eisl-nctu/aquila-net/aquila_hw_network/network_module/iprepo/arp_server_subnet/doc/ReleaseNotes.txt

# ==============================================================
# Vivado(TM) HLS - High-Level Synthesis from C, C++ and SystemC v2019.1 (64-bit)
# Copyright 1986-2019 Xilinx, Inc. All Rights Reserved.
# ==============================================================

Family       : kintex7
Device       : xc7k325t
Package      : -ffg900
Speed Grade  : -2
Clock Period : 6.400 ns
