eisl-nctu/aquila-net/aquila_lwip/sw/socket_echo/lwipopts.h

#define LWIP_LWIPOPTS_H
#define DEFAULT_UDP_RECVMBOX_SIZE       10
#define DEFAULT_TCP_RECVMBOX_SIZE       10
#define DEFAULT_ACCEPTMBOX_SIZE         10
#define DEFAULT_THREAD_STACKSIZE        4096
#define TCPIP_THREAD_NAME               "lwip"
#define TCPIP_THREAD_STACKSIZE          4096
#define TCPIP_MBOX_SIZE                 4
#define TCPIP_THREAD_PRIO               6
#define LWIP_IPV4                  1
#define LWIP_IPV6                  0
#define NO_SYS                     0
#define LWIP_SOCKET                (NO_SYS==0)
#define LWIP_NETCONN               (NO_SYS==0)
#define LWIP_NETIF_API             (NO_SYS==0)
#define LWIP_IGMP                  LWIP_IPV4
#define LWIP_ICMP                  LWIP_IPV4
#define LWIP_SNMP                  LWIP_UDP
#define MIB2_STATS                 LWIP_SNMP
#ifdef LWIP_HAVE_MBEDTLS
#define LWIP_SNMP_V3               (LWIP_SNMP)
#endif
#define LWIP_DNS                   LWIP_UDP
#define LWIP_MDNS_RESPONDER        LWIP_UDP
#define LWIP_NUM_NETIF_CLIENT_DATA (LWIP_MDNS_RESPONDER)
#define LWIP_HAVE_LOOPIF           1
#define LWIP_NETIF_LOOPBACK        1
#define LWIP_LOOPBACK_MAX_PBUFS    10
#define TCP_LISTEN_BACKLOG         1
#define LWIP_COMPAT_SOCKETS        0
#define LWIP_SO_RCVTIMEO           1
#define LWIP_SO_RCVBUF             1
#define LWIP_TCPIP_CORE_LOCKING    1
#define LWIP_NETIF_LINK_CALLBACK        0
#define LWIP_NETIF_STATUS_CALLBACK      0
#define LWIP_NETIF_EXT_STATUS_CALLBACK  0
#define LWIP_DBG_TYPES_ON         (LWIP_DBG_ON|LWIP_DBG_TRACE|LWIP_DBG_STATE|LWIP_DBG_FRESH|LWIP_DBG_HALT)
#define MEM_ALIGNMENT           4U
#define MEM_SIZE               10240
#define MEMP_NUM_PBUF           16
#define MEMP_NUM_RAW_PCB        3
#define MEMP_NUM_UDP_PCB        4
#define MEMP_NUM_TCP_PCB        5
#define MEMP_NUM_TCP_PCB_LISTEN 8
#define MEMP_NUM_TCP_SEG        16
#define MEMP_NUM_SYS_TIMEOUT    17
#define MEMP_NUM_NETBUF         2
#define MEMP_NUM_NETCONN        10
#define MEMP_NUM_TCPIP_MSG_API   16
#define MEMP_NUM_TCPIP_MSG_INPKT 16
#define PBUF_POOL_SIZE          120
#define PBUF_POOL_BUFSIZE       256
#define SYS_LIGHTWEIGHT_PROT    (NO_SYS==0)
#define LWIP_TCP                1
#define TCP_TTL                 255
#define LWIP_ALTCP              (LWIP_TCP)
#ifdef LWIP_HAVE_MBEDTLS
#define LWIP_ALTCP_TLS          (LWIP_TCP)
#define LWIP_ALTCP_TLS_MBEDTLS  (LWIP_TCP)
#endif
#define TCP_QUEUE_OOSEQ         1
#define TCP_MSS                 2048
#define TCP_SND_BUF             2 * TCP_MSS
#define TCP_SND_QUEUELEN       (4 * TCP_SND_BUF/TCP_MSS)
#define TCP_SNDLOWAT           (TCP_SND_BUF/2)
#define TCP_WND                 (20 * 1024)
#define TCP_MAXRTX              12
#define TCP_SYNMAXRTX           4
#define LWIP_ARP                1
#define ARP_TABLE_SIZE          10
#define ARP_QUEUEING            1
#define IP_FORWARD              1
#define IP_REASSEMBLY           1
#define IP_REASS_MAX_PBUFS      (10 * ((1500 + PBUF_POOL_BUFSIZE - 1) / PBUF_POOL_BUFSIZE))
#define MEMP_NUM_REASSDATA      IP_REASS_MAX_PBUFS
#define IP_FRAG                 1
#define IPV6_FRAG_COPYHEADER    1
#define ICMP_TTL                255
#define LWIP_DHCP               LWIP_UDP
#define DHCP_DOES_ARP_CHECK    (LWIP_DHCP)
#define LWIP_AUTOIP            (LWIP_DHCP)
#define LWIP_DHCP_AUTOIP_COOP  (LWIP_DHCP && LWIP_AUTOIP)
#define LWIP_UDP                1
#define LWIP_UDPLITE            LWIP_UDP
#define UDP_TTL                 255
#define LWIP_RAW                1
#define LWIP_STATS              1
#define LWIP_STATS_DISPLAY      1
#if LWIP_STATS
#define LINK_STATS              1
#define IP_STATS                1
#define ICMP_STATS              1
#define IGMP_STATS              1
#define IPFRAG_STATS            1
#define UDP_STATS               1
#define TCP_STATS               1
#define MEM_STATS               1
#define MEMP_STATS              1
#define PBUF_STATS              1
#define SYS_STATS               1
#endif
#define LWIP_NETBIOS_RESPOND_NAME_QUERY 1
#define PPP_SUPPORT             0
#if PPP_SUPPORT
#define NUM_PPP                 1
#define PPPOE_SUPPORT           1
#define PPPOS_SUPPORT           1
#define PAP_SUPPORT             1
#define CHAP_SUPPORT            1
#define MSCHAP_SUPPORT          0
#define CBCP_SUPPORT            0
#define CCP_SUPPORT             0
#define VJ_SUPPORT              1
#define MD5_SUPPORT             1
#endif
