eisl-nctu/aquila-net/aquila_lwip/aquila_src/soc_top.v

`timescale 1ns / 1ps
// =============================================================================
//  Program : soc_top.v
//  Author  : Chun-Jen Tsai
//  Date    : Feb/16/2020
// -----------------------------------------------------------------------------
//  Description:
//  This is the top-level Aquila IP wrapper for an AXI-based processor SoC.
// -----------------------------------------------------------------------------
//  Revision information:
//
//  This module is based on the soc_top.v module written by Jin-you Wu
//  on Feb/28/2019. The original module was a stand-alone top-level module
//  for an SoC. This rework makes it a module embedded inside an AXI IP.
//
//  Jan/12/2020, by Chun-Jen Tsai:
//    Added a on-chip Tightly-Coupled Memory (TCM) to the aquila SoC.
//
// -----------------------------------------------------------------------------
//  License information:
//
//  This software is released under the BSD-3-Clause Licence,
//  see https://opensource.org/licenses/BSD-3-Clause for details.
//  In the following license statements, "software" refers to the
//  "source code" of the complete hardware/software system.
//
//  Copyright 2019,
//                    Embedded Intelligent Systems Lab (EISL)
//                    Deparment of Computer Science
//                    National Chiao Tung Uniersity
//                    Hsinchu, Taiwan.
//
//  All rights reserved.
//
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
//  3. Neither the name of the copyright holder nor the names of its contributors
//     may be used to endorse or promote products derived from this software
//     without specific prior written permission.
//
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
module soc_top #( parameter XLEN = 32, parameter CLSIZE = 256 )
(
    input           sys_clk_p,
    input           sys_clk_n,
    input           reset,

    // ddr3
    output [13 : 0] ddr3_addr,
    output [2 : 0]  ddr3_ba,
    output          ddr3_cas_n,
    output [0 : 0]  ddr3_ck_n,
    output [0 : 0]  ddr3_ck_p,
    output [0 : 0]  ddr3_cke,
    output          ddr3_ras_n,
    output          ddr3_reset_n,
    output          ddr3_we_n,
    inout  [63 : 0] ddr3_dq,
    inout  [7 : 0]  ddr3_dqs_n,
    inout  [7 : 0]  ddr3_dqs_p,
    output [0 : 0]  ddr3_cs_n,
    output [7 : 0]  ddr3_dm,
    output [0 : 0]  ddr3_odt,

    // sdcard
    output          spi_mosi,
    input           spi_miso,
    output          spi_sck,
    output [0:0]    spi_ss,

    // uart
    input           uart_rx,
    output          uart_tx,

    // buttons & leds
    input  [0 : 4]  usr_btn,
    output [0 : 4]  usr_led,

    // ethernet (1000BASE-T SGMII)
    input           phy_sgmii_rx_p,
    input           phy_sgmii_rx_n,
    output          phy_sgmii_tx_p,
    output          phy_sgmii_tx_n,
    input           phy_sgmii_clk_p,
    input           phy_sgmii_clk_n,
    output          phy_reset_n,
    input           phy_int_n
);

wire ui_clk, clk, clk_125;
wire ui_rst;
reg  rst;

wire phy_sgmii_resetdone;

// --------- External memory interface -----------------------------------------
// Instruction memory ports
wire                IMEM_strobe;
wire [XLEN-1 : 0]   IMEM_addr;
wire                IMEM_done;
wire [CLSIZE-1 : 0] IMEM_data;

// Data memory ports
wire                DMEM_strobe;
wire [XLEN-1 : 0]   DMEM_addr;
wire                DMEM_rw;
wire [CLSIZE-1 : 0] DMEM_wt_data;
wire                DMEM_done;
wire [CLSIZE-1 : 0] DMEM_rd_data;

// --------- I/O device interface ----------------------------------------------
// Device bus signals
wire                dev_strobe;
wire [XLEN-1 : 0]   dev_addr;
wire                dev_we;
wire [XLEN/8-1 : 0] dev_be;
wire [XLEN-1 : 0]   dev_din;
wire [XLEN-1 : 0]   dev_dout;
wire                dev_ready;

// --------- cdc_sync ----------------------------------------------------------
// Instruction Memory
wire                IMEM_strobe_ui_clk;
wire [XLEN-1 : 0]   IMEM_addr_ui_clk;
wire                IMEM_done_ui_clk;
wire [CLSIZE-1 : 0] IMEM_data_ui_clk;

// Data Memory
wire                DMEM_strobe_ui_clk;
wire [XLEN-1 : 0]   DMEM_addr_ui_clk;
wire                DMEM_rw_ui_clk;
wire [CLSIZE-1 : 0] DMEM_wt_data_ui_clk;
wire                DMEM_done_ui_clk;
wire [CLSIZE-1 : 0] DMEM_rd_data_ui_clk;

// --------- Memory Controller Interface ---------------------------------------
// Xilinx MIG memory controller user-logic interface signals
wire [27:0]         MEM_addr;
wire [2:0]          MEM_cmd;
wire                MEM_en;
wire [511:0]        MEM_wdf_data;
wire                MEM_wdf_end;
wire [63:0]         MEM_wdf_mask;
wire                MEM_wdf_wren;
wire [511:0]        MEM_rd_data;
wire                MEM_rd_data_end;
wire                MEM_rd_data_valid;
wire                MEM_rdy;
wire                MEM_wdf_rdy;
wire                MEM_sr_req;
wire                MEM_ref_req;
wire                MEM_zq_req;
wire                MEM_sr_active;
wire                MEM_ref_ack;
wire                MEM_zq_ack;
wire                MEM_calib;

// SPI for SD Card
wire                spi_sel;
wire [XLEN-1 : 0]   spi_dout;
wire                spi_ready;

// Uart
wire                uart_sel;
wire [XLEN-1 : 0]   uart_dout;
wire                uart_ready;

// Ethernet mac
wire                eth_sel;
wire [XLEN-1 : 0]   eth_dout;
wire                eth_ready;

// --------- System Clock Generator --------------------------------------------
clk_wiz_0 Clock_Generator(
    .clk_in1(ui_clk),  // Clock input from the MIG controller.
    .clk_out1(clk),    // Clock output to aquila_top
    .clk_out2(clk_125) // Clock output to SGMII
);

// Put the CPU in reset mode for 8 cycles to make sure all
// pipeline registers are properly initialized.
reg [7 : 0] rst_count;

always @(posedge clk)
begin
    if (ui_rst)
        rst_count <= 8'd8;
    else
        rst_count <= rst_count - (| rst_count);
end

// Synchronize the reset signal across the clock domains.
always @(posedge clk)
    rst <= (| rst_count);

// -----------------------------------------------------------------------------
//  Aquila processor core.
//
aquila_top Aquila_SoC
(
    .clk_i(clk),
    .rst_i(rst),          // level-sensitive reset signal.
    .base_addr_i(32'b0),  // initial program counter.
    .ext_irq_i(1'b0),     // no external device interrupts.

    // External instruction memory ports.
    .M_IMEM_strobe_o(IMEM_strobe),
    .M_IMEM_addr_o(IMEM_addr),
    .M_IMEM_done_i(IMEM_done),
    .M_IMEM_data_i(IMEM_data),

    // External data memory ports.
    .M_DMEM_strobe_o(DMEM_strobe),
    .M_DMEM_addr_o(DMEM_addr),
    .M_DMEM_rw_o(DMEM_rw),
    .M_DMEM_data_o(DMEM_wt_data),
    .M_DMEM_done_i(DMEM_done),
    .M_DMEM_data_i(DMEM_rd_data),

    // I/O device ports.
    .M_DEVICE_strobe_o(dev_strobe),
    .M_DEVICE_addr_o(dev_addr),
    .M_DEVICE_rw_o(dev_we),
    .M_DEVICE_byte_enable_o(dev_be),
    .M_DEVICE_data_o(dev_din),
    .M_DEVICE_data_ready_i(dev_ready),
    .M_DEVICE_data_i(dev_dout)
);

// -----------------------------------------------------------------------------
//  Device address decoder.
//
assign uart_sel  = (dev_addr[XLEN-1:XLEN-8] == 8'hC0);
assign spi_sel   = (dev_addr[XLEN-1:XLEN-8] == 8'hC2);
assign eth_sel   = (dev_addr[XLEN-1:XLEN-8] == 8'hC3);
assign dev_dout  = (uart_sel)? uart_dout  : (spi_sel)? spi_dout  : (eth_sel)? eth_dout  : {XLEN{1'b0}};
assign dev_ready = (uart_sel)? uart_ready : (spi_sel)? spi_ready : (eth_sel)? eth_ready : {XLEN{1'b0}};

// ----------------------------------------------------------------------------
//  UART Controller with a simple memory-mapped I/O interface.
//
`define BOARD_CLK	100_000_000
`define BAUD_RATE	115200

uart #(.BAUD(`BOARD_CLK/`BAUD_RATE))
UART(
    .clk(clk),
    .rst(rst),

    .EN(dev_strobe & uart_sel),
    .ADDR(dev_addr[3:2]),
    .WR(dev_we),
    .BE(dev_be),
    .DATAI(dev_din),
    .DATAO(uart_dout),
    .READY(uart_ready),

    .RXD(uart_rx),
    .TXD(uart_tx)
);

// -----------------------------------------------------------------------------
//  SD Card SPI Controller with AXI bus interface.
//
reg               axi_arvalid, axi_awvalid;
wire              axi_arready, axi_awready, axi_wready, axi_bvalid, axi_rvalid;
wire [1 : 0]      axi_bresp, axi_rresp;
reg               axi_bready, axi_rready, axi_wvalid;
reg  [6 : 0]      axi_awaddr, axi_araddr;
wire [XLEN-1 : 0] axi_rdata;
reg               read_done, write_done;
reg  [XLEN-1 : 0] spi_rdata;
wire              io0_t_dummy, io1_t_dummy, sck_t_dummy, ss_t_dummy;
wire              io1_o_dummy, irpt_dummy;

assign spi_dout = spi_rdata;
assign spi_ready = write_done || read_done;

// Check for write_done completion.
always @(posedge clk)
begin
    if (axi_bvalid && axi_bready) // The write_done should be associated
        write_done <= 1;          //     with a bready response.
    else
        write_done <= 0;
end

// Check for read_done completion.
always @(posedge clk)
begin
    if (axi_rvalid && axi_rready) // The read_done should be associated
    read_done <= 1;               //     with a rready response.
else
    read_done <= 0;
end

// Flag any write errors.
wire write_resp_error = (axi_bready & axi_bvalid & axi_bresp[1]);

// Flag any read errors.
wire read_resp_error = (axi_rready & axi_rvalid & axi_rresp[1]);

// -----------------------
//  Write Address Channel
// -----------------------
always @(posedge clk)
begin
    if (rst)
        axi_awvalid <= 0;
    else if (dev_strobe & spi_sel & dev_we)
        axi_awvalid <= 1;
    else if (axi_awvalid & axi_awready)
        axi_awvalid <= 0;
    else
        axi_awvalid <= axi_awvalid;
end

always @(posedge clk) // Write Addresses
begin
    if (rst)
        axi_awaddr <= 0;
    else if (dev_strobe & spi_sel & dev_we)
        axi_awaddr <= dev_addr[6 : 0];
end

// --------------------
//  Write Data Channel
// --------------------
always @(posedge clk)
begin
    if (rst)
        axi_wvalid <= 0;
    else if (dev_strobe & spi_sel & dev_we)
        axi_wvalid <= 1;
    else if (axi_wready & axi_wvalid)  // Data accepted by the slave
        axi_wvalid <= 0;                //  (slave issued M_AXI_WREADY).
    else
        axi_wvalid <= axi_wvalid;
end

// ----------------------------
//  Write Response (B) Channel
// ----------------------------
always @(posedge clk)
begin
    if (rst)
        axi_bready <= 0;
    else if (axi_bvalid & ~axi_bready) // Accept/ack. bresp with axi_bready
        axi_bready <= 1;               // by the master when axi_bvalid
    else if (axi_bready)               // is asserted by slave.
        axi_bready <= 0;               // Deassert after one clock cycle.
    else
        axi_bready <= axi_bready;      // Retain the previous value.
end

// ----------------------
//  Read Address Channel
// ----------------------
always @(posedge clk)
begin
    if (rst)
        axi_arvalid <= 0;
    else if (dev_strobe & spi_sel & ~dev_we)
        axi_arvalid <= 1;
    else if (axi_arready & axi_arvalid)
        axi_arvalid <= 0;
    else
        axi_arvalid <= axi_arvalid;
end

always @(posedge clk) // Read Addresses
begin
    if (rst)
        axi_araddr <= 0;
    else if (dev_strobe & spi_sel & ~dev_we)
        axi_araddr <= dev_addr[6 : 0];
end

// ----------------------------------
//  Read Data (and Response) Channel
// ----------------------------------
always @(posedge clk)
begin
    if (rst)
        axi_rready <= 0;
    else if (axi_rvalid & ~axi_rready) // Accept/ack. rdata/rresp with
        axi_rready <= 1;               // axi_rready by the master when
    else if (axi_rready)               // M_AXI_RVALID is asserted by slave.
        axi_rready <= 0;               // Deassert after one clock cycle.
    else
        axi_rready <= axi_rready;
end

always @(posedge clk)
begin
    if (rst)
        spi_rdata <= {XLEN{1'b0}};
    else if (axi_rvalid)
        spi_rdata <= axi_rdata;
    else
        spi_rdata <= spi_rdata;
end

// ----------------------------------
//  SPI controller
// ----------------------------------
axi_quad_spi_0 SD_Card_Controller(
        .ext_spi_clk(clk),
        .s_axi_aclk(clk),
        .s_axi_aresetn(~rst),
        .s_axi_awaddr(axi_awaddr),
        .s_axi_awvalid(axi_awvalid),        // master signals write addr/ctrl valid.
        .s_axi_awready(axi_awready),        // slave ready to fetch write address.
        .s_axi_wdata(dev_din),              // write data to the slave.
        .s_axi_wstrb(dev_be),               // byte select signal for write operation.
        .s_axi_wvalid(axi_wvalid),          // master signals write data is valid.
        .s_axi_wready(axi_wready),          // slave ready to accept the write data.
        .s_axi_araddr(axi_araddr),
        .s_axi_arready(axi_arready),        // slave ready to fetch read address.
        .s_axi_arvalid(axi_arvalid),        // master signals read addr/ctrl valid.
        .s_axi_bready(axi_bready),          // master is ready to accept the response.
        .s_axi_bresp(axi_bresp),            // reponse code from the slave.
        .s_axi_bvalid(axi_bvalid),          // slave has sent the respond signal.
        .s_axi_rdata(axi_rdata),            // read data from the slave.
        .s_axi_rready(axi_rready),          // master is ready to accept the read data.
        .s_axi_rresp(axi_rresp),            // slave sent read response.
        .s_axi_rvalid(axi_rvalid),          // slave signals read data ready.
        .io0_i(1'b0),
        .io0_o(spi_mosi),
        .io0_t(io0_t_dummy),                // tag signal for mosi (ignore it)
        .io1_i(spi_miso),
        .io1_o(io1_o_dummy),                // output signal for io1 (ignore it)
        .io1_t(io1_t_dummy),                // tag signal for miso (ignore it)
        .sck_i(1'b0),
        .sck_o(spi_sck),
        .sck_t(sck_t_dummy),                // tag signal for sck (ignore it)
        .ss_i(1'b0),
        .ss_o(spi_ss),
        .ss_t(ss_t_dummy),                  // tag signal for ss (ignore it)
        .ip2intc_irpt(irpt_dummy)           // interrupt from SPI controller (ignore it)
);

// ----------------------------------
//  ETHERNET MAC CORE
// ----------------------------------

ethernet_mac_sgmii_core  ethernet_mac_sgmii_core_inst(
    // System clock & reset
    .clk(clk),
    .rst(rst),
    // 125MHz clock (for SGMII)
    .clk_125(clk_125),
    // Ethernet: 1000BASE-T SGMII
    .phy_sgmii_rx_p(phy_sgmii_rx_p),
    .phy_sgmii_rx_n(phy_sgmii_rx_n),
    .phy_sgmii_tx_p(phy_sgmii_tx_p),
    .phy_sgmii_tx_n(phy_sgmii_tx_n),
    .phy_sgmii_clk_p(phy_sgmii_clk_p),
    .phy_sgmii_clk_n(phy_sgmii_clk_n),
    .phy_reset_n(phy_reset_n),
    .phy_int_n(phy_int_n),
    // Ethernet status output
    .phy_sgmii_resetdone(phy_sgmii_resetdone),
    // User interface
    .strobe_i(dev_strobe && eth_sel),
    .addr_i(dev_addr),
    .we_i(dev_we),
    .data_i(dev_din),
    .done_o(eth_ready),
    .data_o(eth_dout)
);

// ----------------------------------------------------------------------------
//  cdc_sync.
//
cdc_sync synchronizer
(
    .clk_core(clk),
    .clk_memc(ui_clk),
    .rst_i(rst),

    .IMEM_strobe_i(IMEM_strobe),
    .IMEM_addr_i(IMEM_addr),
    .IMEM_done_o(IMEM_done),
    .IMEM_data_o(IMEM_data),

    .DMEM_strobe_i(DMEM_strobe),
    .DMEM_addr_i(DMEM_addr),
    .DMEM_rw_i(DMEM_rw),
    .DMEM_wt_data_i(DMEM_wt_data),
    .DMEM_done_o(DMEM_done),
    .DMEM_rd_data_o(DMEM_rd_data),

    .IMEM_strobe_o(IMEM_strobe_ui_clk),
    .IMEM_addr_o(IMEM_addr_ui_clk),
    .IMEM_done_i(IMEM_done_ui_clk),
    .IMEM_data_i(IMEM_data_ui_clk),

    .DMEM_strobe_o(DMEM_strobe_ui_clk),
    .DMEM_addr_o(DMEM_addr_ui_clk),
    .DMEM_rw_o(DMEM_rw_ui_clk),
    .DMEM_wt_data_o(DMEM_wt_data_ui_clk),
    .DMEM_done_i(DMEM_done_ui_clk),
    .DMEM_rd_data_i(DMEM_rd_data_ui_clk)
);

// ----------------------------------------------------------------------------
//  mem_arbiter.
//
mem_arbiter Memory_Arbiter
(
    // System signals
    .clk_i(ui_clk),
    .rst_i(rst),

    // Aquila M_ICACHE master port interface signals
    .S_IMEM_strobe_i(IMEM_strobe_ui_clk),
    .S_IMEM_addr_i(IMEM_addr_ui_clk),
    .S_IMEM_done_o(IMEM_done_ui_clk),
    .S_IMEM_data_o(IMEM_data_ui_clk),

    // Aquila M_DCACHE master port interface signals
    .S_DMEM_strobe_i(DMEM_strobe_ui_clk),
    .S_DMEM_addr_i(DMEM_addr_ui_clk),
    .S_DMEM_rw_i(DMEM_rw_ui_clk),
    .S_DMEM_data_i(DMEM_wt_data_ui_clk),
    .S_DMEM_done_o(DMEM_done_ui_clk),
    .S_DMEM_data_o(DMEM_rd_data_ui_clk),
    
    // memory user interface signals
    .M_MEM_addr_o(MEM_addr),
    .M_MEM_cmd_o(MEM_cmd),
    .M_MEM_en_o(MEM_en),
    .M_MEM_wdf_data_o(MEM_wdf_data),
    .M_MEM_wdf_end_o(MEM_wdf_end),
    .M_MEM_wdf_mask_o(MEM_wdf_mask),
    .M_MEM_wdf_wren_o(MEM_wdf_wren),
    .M_MEM_rd_data_i(MEM_rd_data),
    .M_MEM_rd_data_valid_i(MEM_rd_data_valid),
    .M_MEM_rdy_i(MEM_rdy),
    .M_MEM_wdf_rdy_i(MEM_wdf_rdy),
    .M_MEM_sr_req_o(MEM_sr_req),
    .M_MEM_ref_req_o(MEM_ref_req),
    .M_MEM_zq_req_o(MEM_zq_req)
);

// ----------------------------------------------------------------------------
//  MIG.
//
mig_7series_0 MIG(

    // Memory interface ports
    .ddr3_addr(ddr3_addr),                  // output [13:0]  ddr3_addr
    .ddr3_ba(ddr3_ba),                      // output [2:0]   ddr3_ba
    .ddr3_cas_n(ddr3_cas_n),                // output         ddr3_cas_n
    .ddr3_ck_n(ddr3_ck_n),                  // output [0:0]   ddr3_ck_n
    .ddr3_ck_p(ddr3_ck_p),                  // output [0:0]   ddr3_ck_p
    .ddr3_cke(ddr3_cke),                    // output [0:0]   ddr3_cke
    .ddr3_ras_n(ddr3_ras_n),                // output         ddr3_ras_n
    .ddr3_reset_n(ddr3_reset_n),            // output         ddr3_reset_n
    .ddr3_we_n(ddr3_we_n),                  // output         ddr3_we_n
    .ddr3_dq(ddr3_dq),                      // inout [15:0]   ddr3_dq
    .ddr3_dqs_n(ddr3_dqs_n),                // inout [1:0]    ddr3_dqs_n
    .ddr3_dqs_p(ddr3_dqs_p),                // inout [1:0]    ddr3_dqs_p
    .init_calib_complete(MEM_calib),        // output         init_calib_complete

    .ddr3_cs_n(ddr3_cs_n),                  // output [0:0]   ddr3_cs_n
    .ddr3_dm(ddr3_dm),                      // output [1:0]   ddr3_dm
    .ddr3_odt(ddr3_odt),                    // output [0:0]   ddr3_odt

    // Application interface ports
    .app_addr(MEM_addr),                    // input [27:0]   app_addr
    .app_cmd(MEM_cmd),                      // input [2:0]    app_cmd
    .app_en(MEM_en),                        // input          app_en
    .app_wdf_data(MEM_wdf_data),            // input [127:0]  app_wdf_data
    .app_wdf_end(MEM_wdf_end),              // input          app_wdf_end
    .app_wdf_mask(MEM_wdf_mask),            // input [15:0]   app_wdf_mask
    .app_wdf_wren(MEM_wdf_wren),            // input          app_wdf_wren
    .app_rd_data(MEM_rd_data),              // output [127:0] app_rd_data
    .app_rd_data_end(MEM_rd_data_end),      // output         app_rd_data_end
    .app_rd_data_valid(MEM_rd_data_valid),  // output         app_rd_data_valid
    .app_rdy(MEM_rdy),                      // output         app_rdy
    .app_wdf_rdy(MEM_wdf_rdy),              // output         app_wdf_rdy
    .app_sr_req(MEM_sr_req),                // input          app_sr_req
    .app_ref_req(MEM_ref_req),              // input          app_ref_req
    .app_zq_req(MEM_zq_req),                // input          app_zq_req
    .app_sr_active(MEM_sr_active),          // output         app_sr_active
    .app_ref_ack(MEM_ref_ack),              // output         app_ref_ack
    .app_zq_ack(MEM_zq_ack),                // output         app_zq_ack

    // System Clock & Reset Ports
    .sys_clk_n(sys_clk_n),                  // input          memory controller ref. clock
    .sys_clk_p(sys_clk_p),
    .sys_rst(reset),                        // input          sys_rst

    // 200MHz Reference Clock Ports (only needed when the ui_clk is not 200MHz)
    // .clk_ref_i(clk_200M),

    .ui_clk(ui_clk),                        // output         ui_clk
    .ui_clk_sync_rst(ui_rst)                // output         ui_clk_sync_rst
);

endmodule
