eisl-nctu/aquila-net/aquila_hw_network/network_module/iprepo/arp_server_subnet/hdl/vhdl/arp_server_subnet_top_mux_646_64_1_1.vhd

-- ==============================================================
-- Vivado(TM) HLS - High-Level Synthesis from C, C++ and SystemC v2019.1 (64-bit)
-- Copyright 1986-2019 Xilinx, Inc. All Rights Reserved.
-- ==============================================================

library IEEE;
use IEEE.std_logic_1164.all;
use IEEE.NUMERIC_STD.all;

entity arp_server_subnet_top_mux_646_64_1_1 is
generic (
    ID            :integer := 0;
    NUM_STAGE     :integer := 1;
    din0_WIDTH       :integer := 32;
    din1_WIDTH       :integer := 32;
    din2_WIDTH       :integer := 32;
    din3_WIDTH       :integer := 32;
    din4_WIDTH       :integer := 32;
    din5_WIDTH       :integer := 32;
    din6_WIDTH       :integer := 32;
    din7_WIDTH       :integer := 32;
    din8_WIDTH       :integer := 32;
    din9_WIDTH       :integer := 32;
    din10_WIDTH       :integer := 32;
    din11_WIDTH       :integer := 32;
    din12_WIDTH       :integer := 32;
    din13_WIDTH       :integer := 32;
    din14_WIDTH       :integer := 32;
    din15_WIDTH       :integer := 32;
    din16_WIDTH       :integer := 32;
    din17_WIDTH       :integer := 32;
    din18_WIDTH       :integer := 32;
    din19_WIDTH       :integer := 32;
    din20_WIDTH       :integer := 32;
    din21_WIDTH       :integer := 32;
    din22_WIDTH       :integer := 32;
    din23_WIDTH       :integer := 32;
    din24_WIDTH       :integer := 32;
    din25_WIDTH       :integer := 32;
    din26_WIDTH       :integer := 32;
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

-- Generate level 5 logic
mux_5_0 <= mux_4_0 when sel(4) = '0' else mux_4_1;
mux_5_1 <= mux_4_2 when sel(4) = '0' else mux_4_3;

-- Generate level 6 logic
mux_6_0 <= mux_5_0 when sel(5) = '0' else mux_5_1;

-- output logic
dout <= mux_6_0;

end architecture;
