eisl-nctu/aquila-net/aquila_lwip/aquila_src/core_rtl/decode.v

`timescale 1ns / 1ps
// =============================================================================
//  Program : decode.v
//  Author  : Jin-you Wu
//  Date    : Dec/19/2018
// -----------------------------------------------------------------------------
//  Description:
//  This is the Decoding Unit of the Aquila core (A RISC-V core).
// -----------------------------------------------------------------------------
//  Revision information:
//
//  Nov/29/2019, by Chun-Jen Tsai:
//    Merges the pipeline register moduel 'decode_execute' into the 'decode'
//    module.
// -----------------------------------------------------------------------------
//  License information:
//
//  This software is released under the BSD-3-Clause Licence,
//  see https://opensource.org/licenses/BSD-3-Clause for details.
//  In the following license statements, "software" refers to the
//  "source code" of the complete hardware/software system.
//
//  Copyright 2019,
//                    Embedded Intelligent Systems Lab (EISL)
//                    Deparment of Computer Science
//                    National Chiao Tung Uniersity
//                    Hsinchu, Taiwan.
//
//  All rights reserved.
//
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
//  3. Neither the name of the copyright holder nor the names of its contributors
//     may be used to endorse or promote products derived from this software
//     without specific prior written permission.
//
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
module decode #(parameter XLEN = 32)
(
    //  Processor clock and reset signals.
    input                   clk_i,
    input                   rst_i,

    // Pipeline stall signal.
    input                   stall_i,

    // Pipeline flush signal.
    input                   flush_i,

    // From Fetch.
    input  [XLEN-1 : 0]     pc_i,
    input  [XLEN-1 : 0]     instruction_i,
    input                   branch_hit_i,
    input                   branch_decision_i,

    // From CSR
    input  [XLEN-1 : 0]     csr_data_i,
    input  [ 1 : 0]         privilege_lvl_i,

    // Instruction operands from the Register File. To be forwarded.
    input  [XLEN-1 : 0]     rs1_data_i,
    input  [XLEN-1 : 0]     rs2_data_i,

    // to Pipeline Control
    output                  is_load_hazard_o,

    // Operand register IDs to the RFU
    output [ 4 : 0]         rs1_addr_o,
    output [ 4 : 0]         rs2_addr_o,

    // illegal
    output                  unsupported_instr_o,

    // to Execute
    output reg [XLEN-1 : 0] imm_o,
    output reg [ 1 : 0]     inputA_sel_o,
    output reg [ 1 : 0]     inputB_sel_o,
    output reg [ 2 : 0]     operation_sel_o,
    output reg              alu_muldiv_sel_o,
    output reg              shift_sel_o,
    output reg              branch_hit_o,
    output reg              branch_decision_o,
    output reg              is_jalr_o,
    output reg              is_fencei_o,

    // to Execute and BPU
    output reg [XLEN-1 : 0] pc_o, // also to CSR
    output reg              is_branch_o,
    output reg              is_jal_o,

    // to CSR
    output reg              is_csr_instr_o,
    output     [11 : 0]     csr_addr_o,
    output reg [ 4 : 0]     csr_imm_o,

    // to Execute
    output reg [ 4 : 0]     rd_addr_o,
    output reg              regfile_we_o,
    output reg [ 2 : 0]     regfile_input_sel_o,
    output reg              we_o,
    output reg              re_o,
    output reg [ 1 : 0]     dsize_sel_o,  // data size select
    output reg              signex_sel_o, // sign-extension select
    output reg              is_amo_o,
    output reg [ 4 : 0]     amo_type_o,

    // to Forwarding_Unit
    output reg [4 : 0]      rs1_addr2fwd_o,
    output reg [4 : 0]      rs2_addr2fwd_o,
    output reg [XLEN-1 : 0] rs1_data2fwd_o,
    output reg [XLEN-1 : 0] rs2_data2fwd_o,
    output reg [11 : 0]     csr_addr2fwd_o,
    output reg [XLEN-1 : 0] csr_data2fwd_o,

    // System Jump operation
    output reg              sys_jump_o,
    output reg [ 1 : 0]     sys_jump_csr_addr_o,

     // Has instruction fetch being successiful?
    input                   fetch_valid_i,
    output reg              fetch_valid_o,

    // Exception info passed from Fetch to Execute.
    input                   xcpt_valid_i,
    input  [ 3 : 0]         xcpt_cause_i,
    input  [XLEN-1 : 0]     xcpt_tval_i,
    output reg              xcpt_valid_o,
    output reg [ 3 : 0]     xcpt_cause_o,
    output reg [XLEN-1 : 0] xcpt_tval_o
);

// Interal signals of the Decode Stage.
wire [XLEN-1 : 0] imm;
wire [ 4 : 0]     rd_addr;
wire              we;
wire              re;
wire              regfile_we;
reg  [ 1 : 0]     inputA_sel;
reg  [ 1 : 0]     inputB_sel;
reg  [ 2 : 0]     regfile_input_sel;
wire [ 2 : 0]     operation_sel;
wire [ 1 : 0]     dsize_sel;
wire              signex_sel;     // for lb, lbu, lh and lhu.
wire              alu_muldiv_sel; // for rv32m operation.
wire              shift_sel;      // for shift right operation.
wire [ 4 : 0]     csr_imm;

/* *******************************************************************************
 * Info Signals Description                                                      *
 * ----------------------------------------------------------------------------- *
 *      There are 2 inputs for the exe:                                          *
 *          # inputA has 4 possible sources, determined by inputA_sel:           *
 *              (0) 0 (LUI)                                                      *
 *              (1) pc (AUIPC, JAL, BRANCH)                                      *
 *              (2) rs1                                                          *
 *          # inputB has 3 possible sources, determined by inputB_sel:           *
 *              (0) imm                                                          *
 *              (1) rs2                                                          *
 *              (2) -rs2 (SUB)                                                   *
 * ----------------------------------------------------------------------------- *
 *      There are 6 possible input sources to the register file, determined by   *
 *      regfile_input_sel:                                                       *
 *              (0) one byte from data memory                                    *
 *              (1) half of word from data memory                                *
 *              (2) word from data memory                                        *
 *              (3) pc + 4 (pc of next instruction)                              *
 *              (4) execute result                                               *
 *              (5) csr value                                                    *
 * ----------------------------------------------------------------------------- *
 *      Usage of operation_sel are listed below:                                 *
 *          # Conditional branch                                                 *
 *              (0) 3'b000 : equal                                               *
 *              (1) 3'b001 : not equal                                           *
 *              (2) 3'b100 : less than                                           *
 *              (3) 3'b101 : greater than or equal to                            *
 *              (4) 3'b110 : less than unsigned                                  *
 *              (5) 3'b111 : greater than or equal to                            *
 *          # RVI, alu_muldiv_sel = 0                                            *
 *              (0) 3'b000 : add (add/sub)                                       *
 *              (1) 3'b001 : sll (shift left logic)                              *
 *              (2) 3'b010 : slt (set less than)                                 *
 *              (3) 3'b011 : sltu (set less than unsigned)                       *
 *              (4) 3'b100 : xor                                                 *
 *              (5) 3'b101 : sr (shift right logic/arithmetic)                   *
 *              (6) 3'b110 : or                                                  *
 *              (7) 3'b111 : and                                                 *
 *          # RVM, alu_muldiv_sel = 1                                            *
 *              (0) 3'b000 : mul                                                 *
 *              (1) 3'b001 : mulh                                                *
 *              (2) 3'b010 : mulhsu                                              *
 *              (3) 3'b011 : mulhu                                               *
 *              (4) 3'b100 : div                                                 *
 *              (5) 3'b101 : divu                                                *
 *              (6) 3'b110 : rem                                                 *
 *              (7) 3'b111 : remu                                                *
 *          # RVI, CSR instructions  (csr_op)                                    *
 *              (0) 3'b001 : csrrw                                               *
 *              (1) 3'b010 : csrrs                                               *
 *              (2) 3'b011 : csrrc                                               *
 *              (3) 3'b101 : csrrwi                                              *
 *              (4) 3'b110 : csrrsi                                              *
 *              (5) 3'b111 : csrrci                                              *
 * ----------------------------------------------------------------------------- *
 *      Bytes of load data or store data, determined by data_size_sel            *
 *              (0) 2'b00 : byte                                                 *
 *              (1) 2'b01 : half word                                            *
 *              (2) 2'b10 : word                                                 *
 * *******************************************************************************/

wire [XLEN-1 : 0] rv32_instr = instruction_i;
wire [ 6 : 0]     opcode = rv32_instr[6: 0];
wire [ 4 : 0]     rv32_shamt = rv32_instr[24: 20];
wire [ 2 : 0]     rv32_funct3 = rv32_instr[14: 12];
wire [ 6 : 0]     rv32_funct7 = rv32_instr[XLEN-1 : 25];
wire [ 4 : 0]     amo_type = rv32_instr[XLEN-1 : 27];

wire [XLEN-1 : 0] immI, immS, immB, immU, immJ;
assign immI = { {21{rv32_instr[31]}}, rv32_instr[30: 25],
                 rv32_instr[24: 21], rv32_instr[20] };
assign immS = { {21{rv32_instr[31]}}, rv32_instr[30: 25], rv32_instr[11: 7] };
assign immB = { {20{rv32_instr[31]}}, rv32_instr[7],
                 rv32_instr[30: 25], rv32_instr[11: 8], 1'b0 };
assign immU = { rv32_instr[31: 12], 12'b0 };
assign immJ = { {12{rv32_instr[31]}}, rv32_instr[19: 12],
                rv32_instr[20], rv32_instr[30: 25], rv32_instr[24: 21], 1'b0 };

// ================================================================================
//  We generate the signals and reused them as much as possible to save gate counts
//
// wire opcode_1_0_00 = (opcode[1:0] == 2'b00);  // rvc
// wire opcode_1_0_01 = (opcode[1:0] == 2'b01);  // rvc
// wire opcode_1_0_10 = (opcode[1:0] == 2'b10);  // rvc
wire opcode_1_0_11 = (opcode[1: 0] == 2'b11);  // rv32

wire opcode_4_2_000 = (opcode[4: 2] == 3'b000);
wire opcode_4_2_001 = (opcode[4: 2] == 3'b001);
wire opcode_4_2_010 = (opcode[4: 2] == 3'b010);
wire opcode_4_2_011 = (opcode[4: 2] == 3'b011);
wire opcode_4_2_100 = (opcode[4: 2] == 3'b100);
wire opcode_4_2_101 = (opcode[4: 2] == 3'b101);
wire opcode_4_2_110 = (opcode[4: 2] == 3'b110);
wire opcode_4_2_111 = (opcode[4: 2] == 3'b111);

wire opcode_6_5_00 = (opcode[6: 5] == 2'b00);
wire opcode_6_5_01 = (opcode[6: 5] == 2'b01);
wire opcode_6_5_10 = (opcode[6: 5] == 2'b10);
wire opcode_6_5_11 = (opcode[6: 5] == 2'b11);

wire rv32_funct3_000 = (rv32_funct3 == 3'b000);
wire rv32_funct3_001 = (rv32_funct3 == 3'b001);
wire rv32_funct3_010 = (rv32_funct3 == 3'b010);
wire rv32_funct3_011 = (rv32_funct3 == 3'b011);
wire rv32_funct3_100 = (rv32_funct3 == 3'b100);
wire rv32_funct3_101 = (rv32_funct3 == 3'b101);
wire rv32_funct3_110 = (rv32_funct3 == 3'b110);
wire rv32_funct3_111 = (rv32_funct3 == 3'b111);

wire rv32_funct7_0000000 = (rv32_funct7 == 7'b0000000);
wire rv32_funct7_0100000 = (rv32_funct7 == 7'b0100000);
wire rv32_funct7_0000001 = (rv32_funct7 == 7'b0000001);
wire rv32_funct7_0000101 = (rv32_funct7 == 7'b0000101);
wire rv32_funct7_0001001 = (rv32_funct7 == 7'b0001001);
wire rv32_funct7_0001101 = (rv32_funct7 == 7'b0001101);
wire rv32_funct7_0010101 = (rv32_funct7 == 7'b0010101);
wire rv32_funct7_0100001 = (rv32_funct7 == 7'b0100001);
wire rv32_funct7_0010001 = (rv32_funct7 == 7'b0010001);
wire rv32_funct7_0101101 = (rv32_funct7 == 7'b0101101);
wire rv32_funct7_1111111 = (rv32_funct7 == 7'b1111111);
wire rv32_funct7_0000100 = (rv32_funct7 == 7'b0000100);
wire rv32_funct7_0001000 = (rv32_funct7 == 7'b0001000);
wire rv32_funct7_0001100 = (rv32_funct7 == 7'b0001100);
wire rv32_funct7_0101100 = (rv32_funct7 == 7'b0101100);
wire rv32_funct7_0010000 = (rv32_funct7 == 7'b0010000);
wire rv32_funct7_0010100 = (rv32_funct7 == 7'b0010100);
wire rv32_funct7_1100000 = (rv32_funct7 == 7'b1100000);
wire rv32_funct7_1110000 = (rv32_funct7 == 7'b1110000);
wire rv32_funct7_1010000 = (rv32_funct7 == 7'b1010000);
wire rv32_funct7_1101000 = (rv32_funct7 == 7'b1101000);
wire rv32_funct7_1111000 = (rv32_funct7 == 7'b1111000);
wire rv32_funct7_1010001 = (rv32_funct7 == 7'b1010001);
wire rv32_funct7_1110001 = (rv32_funct7 == 7'b1110001);
wire rv32_funct7_1100001 = (rv32_funct7 == 7'b1100001);
wire rv32_funct7_1101001 = (rv32_funct7 == 7'b1101001);

// ================================================================================
//  RV32I Opcode Classification
//
wire rv32_op = opcode_6_5_01 & opcode_4_2_100;      // OP opcode
wire rv32_op_imm = opcode_6_5_00 & opcode_4_2_100;  // OP-IMM opcode
wire rv32_jal = opcode_6_5_11 & opcode_4_2_011;     // JAL opcode
wire rv32_jalr = opcode_6_5_11 & opcode_4_2_001;    // JARL opcode
wire rv32_load = opcode_6_5_00 & opcode_4_2_000;    // LOAD opcode
wire rv32_store = opcode_6_5_01 & opcode_4_2_000;   // STORE opcode
wire rv32_branch = opcode_6_5_11 & opcode_4_2_000;  // BRANCH opcode
wire rv32_lui = opcode_6_5_01 & opcode_4_2_101;     // LUI opcode
wire rv32_auipc = opcode_6_5_00 & opcode_4_2_101;   // AUIPC opcode
wire rv32_miscmem = opcode_6_5_00 & opcode_4_2_011; // MISC-MEM opcode
wire rv32_system = opcode_6_5_11 & opcode_4_2_100;  // SYSTEM opcode
wire rv32_amo = opcode_6_5_01 & opcode_4_2_011;     // AMO opcode

wire rv32m = rv32_op & rv32_funct7_0000001;  // Mul, Div and Rem instructions

wire rv32_imm_seli = rv32_op_imm | rv32_jalr | rv32_load;
wire rv32_imm_sels = rv32_store;
wire rv32_imm_selb = rv32_branch;
wire rv32_imm_selu = rv32_lui | rv32_auipc;
wire rv32_imm_selj = rv32_jal;

wire rv32_sub = rv32_op & rv32_funct3_000 & rv32_funct7_0100000;

// ================================================================================
//  Conditional Branch Instructions
//
wire rv32_beq = rv32_branch & rv32_funct3_000;
wire rv32_bne = rv32_branch & rv32_funct3_001;
wire rv32_blt = rv32_branch & rv32_funct3_100;
wire rv32_bgt = rv32_branch & rv32_funct3_101;
wire rv32_bltu = rv32_branch & rv32_funct3_110;
wire rv32_bgtu = rv32_branch & rv32_funct3_111;

// ================================================================================
//  MISC-MEM
wire rv32_fence  = rv32_miscmem & rv32_funct3_000;
wire rv32_fencei = rv32_miscmem & rv32_funct3_001;

// ================================================================================
//  System Instructions
//
wire rv32_csrrw = rv32_system & rv32_funct3_001;
wire rv32_csrrs = rv32_system & rv32_funct3_010;
wire rv32_csrrc = rv32_system & rv32_funct3_011;
wire rv32_csrrwi = rv32_system & rv32_funct3_101;
wire rv32_csrrsi = rv32_system & rv32_funct3_110;
wire rv32_csrrci = rv32_system & rv32_funct3_111;
wire rv32_csr = rv32_system & (~rv32_funct3_000);

wire rv32_sys_op = rv32_system & rv32_funct3_000;
wire rv32_ecall = rv32_sys_op & (rv32_instr[31: 20] == 12'b0000_0000_0000);
wire rv32_ebreak = rv32_sys_op & (rv32_instr[31: 20] == 12'b0000_0000_0001);
wire rv32_mret = rv32_sys_op & (rv32_instr[31: 20] == 12'b0011_0000_0010);
wire rv32_sret = rv32_sys_op & (rv32_instr[31: 20] == 12'b0001_0000_0010);

// ================================================================================
// Load/Store Instructions
//
wire rv32_lb = rv32_load & rv32_funct3_000;
wire rv32_lh = rv32_load & rv32_funct3_001;
wire rv32_lw = rv32_load & rv32_funct3_010;
wire rv32_lbu = rv32_load & rv32_funct3_100;
wire rv32_lhu = rv32_load & rv32_funct3_101;

wire rv32_sb = rv32_store & rv32_funct3_000;
wire rv32_sh = rv32_store & rv32_funct3_001;
wire rv32_sw = rv32_store & rv32_funct3_010;

// ================================================================================
// Exception Signals
//
wire         xcpt_valid   = rv32_ecall;
wire [ 3: 0] xcpt_cause = (privilege_lvl_i == 2'b11)?'d11:
                         (privilege_lvl_i == 2'b01)?'d9 :'d8;
wire [31: 0] xcpt_tval  = 0;

// ================================================================================
//  Output Signals
//
assign imm =
       ({32{rv32_imm_seli}} & immI)
       | ({32{rv32_imm_sels}} & immS)
       | ({32{rv32_imm_selb}} & immB)
       | ({32{rv32_imm_selu}} & immU)
       | ({32{rv32_imm_selj}} & immJ)
       ;

// All the RV32IMA need rd except the
//   # BRANCH, STORE,
//   # FENCE, FENCE.I
//   # ECALL, EBREAK
assign regfile_we = rv32_lui | rv32_auipc | rv32_load | rv32_op_imm |
                    rv32_op | rv32_csr | rv32_amo | rv32_jal | rv32_jalr;

assign re = rv32_load | rv32_amo; // AMO instr. also need to load d-cache data
assign we = rv32_store | rv32_fencei;

assign rd_addr = rv32_instr[11: 7];
assign rs1_addr_o = rv32_instr[19: 15];
assign rs2_addr_o = rv32_instr[24: 20];

assign dsize_sel = rv32_funct3[1: 0];             // {00: b}, {01: h}, {10: w}
assign signex_sel = rv32_funct3[2];               // {0: signed extension},
                                                  //     {1: unsigned extension}
assign alu_muldiv_sel = rv32m;                    // {0: rv32i op}, {1: rv32m op}
assign operation_sel = (rv32_lui | rv32_auipc) ?  // LUI and AUIPC use alu
       3'b000 : rv32_funct3;                      //      adder result
assign shift_sel = rv32_funct7_0100000;           // {0: logic}, {1: arithmetic}

assign csr_addr_o = rv32_instr[31: 20];
assign csr_imm = rv32_instr[19: 15];

// Detect load structure hazard.
wire is_r_type     = (rv32_op || rv32_system) && opcode_1_0_11;
wire is_i_type     = (rv32_load || rv32_op_imm || rv32_jalr) && opcode_1_0_11;
wire is_s_type     = rv32_store && opcode_1_0_11;
wire is_b_type     = rv32_branch && opcode_1_0_11;
wire is_fence      = rv32_fence && opcode_1_0_11;
wire is_csr_type   = (rv32_csrrw || rv32_csrrs || rv32_csrrc) && opcode_1_0_11;


wire is_rs1_rd_same = (rs1_addr_o == rd_addr_o) &&
                      (is_r_type || is_s_type || is_b_type || is_i_type ||
                       is_fence || is_csr_type);
wire is_rs2_rd_same = (rs2_addr_o == rd_addr_o) && (is_r_type || is_s_type || is_b_type);

assign is_load_hazard_o = (is_rs1_rd_same | is_rs2_rd_same) && re_o;

always @(*)
begin
    if (rv32_auipc | rv32_jal | rv32_branch)
        inputA_sel = 1; // pc
    else if (rv32_lui | rv32_store)
        inputA_sel = 0; // 0
    else
        inputA_sel = 2; // rs1
end

always @(*)
begin
    if (rv32_sub)
        inputB_sel = 2; // -rs2
    else if (rv32_store | rv32_op | rv32_amo)
        inputB_sel = 1; // rs2
    else
        inputB_sel = 0; // immediate
end

always @(*)
begin
    if (rv32_lb | rv32_lbu)
        regfile_input_sel = 0; // load byte
    else if (rv32_lh | rv32_lhu)
        regfile_input_sel = 1; // load half word
    else if (rv32_lw | rv32_amo)
        regfile_input_sel = 2; // load word
    else if (rv32_jal | rv32_jalr)
        regfile_input_sel = 3; // pc+4
    else if (rv32_csr)
        regfile_input_sel = 5; // csr
    else
        regfile_input_sel = 4; // execute result
end

assign unsupported_instr_o =   // the instructions that are not supported currently
         rv32_fence
       | rv32_ebreak;

//////////////////////////////////////////////////////////////////
//  Output to other stages
//////////////////////////////////////////////////////////////////
always @(posedge clk_i)
begin
    if (rst_i || (flush_i && !stall_i)) // stall has higher priority than flush.
    begin
        pc_o <= (flush_i)? pc_i : 0;
        fetch_valid_o <= 0;
        rs1_data2fwd_o <= 0;
        rs2_data2fwd_o <= 0;
        imm_o <= 0;
        inputA_sel_o <= 2;
        inputB_sel_o <= 0;
        operation_sel_o <= 0;
        signex_sel_o <= 0;
        dsize_sel_o <= 0;
        alu_muldiv_sel_o <= 0;
        shift_sel_o <= 0;
        is_branch_o <= 0;
        is_jal_o <= 0;
        is_jalr_o <= 0;
        regfile_we_o <= 1;
        regfile_input_sel_o <= 4; // send Execute result into the RFU.
        we_o <= 0;
        re_o <= 0;
        dsize_sel_o <= 0;
        rd_addr_o <= 0;
        rs1_addr2fwd_o <= 0;
        rs2_addr2fwd_o <= 0;
        is_csr_instr_o <= 0;
        csr_imm_o <= 0;
        branch_hit_o <= 0;
        branch_decision_o <= 0;
        is_fencei_o <= 0;
        amo_type_o <= 0;
        is_amo_o <= 0;

        sys_jump_o <= 0;
        sys_jump_csr_addr_o <= 0;
        xcpt_valid_o <= 0;
        xcpt_cause_o <= 0;
        xcpt_tval_o <= 0;
        csr_data2fwd_o <= 0;
        csr_addr2fwd_o <= 0;
    end
    else if (stall_i)
    begin
        pc_o <= pc_o;
        fetch_valid_o <= fetch_valid_o;
        rs1_data2fwd_o <= rs1_data2fwd_o;
        rs2_data2fwd_o <= rs2_data2fwd_o;
        imm_o <= imm_o;
        inputA_sel_o <= inputA_sel_o;
        inputB_sel_o <= inputB_sel_o;
        operation_sel_o <= operation_sel_o;
        signex_sel_o <= signex_sel_o;
        alu_muldiv_sel_o <= alu_muldiv_sel_o;
        shift_sel_o <= shift_sel_o;
        is_branch_o <= is_branch_o;
        is_jal_o <= is_jal_o;
        is_jalr_o <= is_jalr_o;
        regfile_we_o <= regfile_we_o;
        regfile_input_sel_o <= regfile_input_sel_o;
        we_o <= we_o;
        re_o <= re_o;
        dsize_sel_o <= dsize_sel_o;
        rd_addr_o <= rd_addr_o;
        rs1_addr2fwd_o <= rs1_addr2fwd_o;
        rs2_addr2fwd_o <= rs2_addr2fwd_o;
        is_csr_instr_o <= is_csr_instr_o;
        csr_imm_o <= csr_imm_o;
        branch_hit_o <= branch_hit_o;
        branch_decision_o <= branch_decision_o;
        is_fencei_o <= is_fencei_o;
        amo_type_o <= amo_type_o;
        is_amo_o <= is_amo_o;

        sys_jump_o <= sys_jump_o;
        sys_jump_csr_addr_o <= sys_jump_csr_addr_o;
        xcpt_valid_o <= xcpt_valid_o;
        xcpt_cause_o <= xcpt_cause_o;
        xcpt_tval_o <= xcpt_tval_o;
        csr_data2fwd_o <= csr_data2fwd_o;
        csr_addr2fwd_o <= csr_addr2fwd_o;
    end
    else if (xcpt_valid)
    begin
        pc_o <= pc_i;
        fetch_valid_o <= 1;
        rs1_data2fwd_o <= 0;
        rs2_data2fwd_o <= 0;
        imm_o <= 0;
        inputA_sel_o <= 2;
        inputB_sel_o <= 0;
        operation_sel_o <= 0;
        signex_sel_o <= 0;
        dsize_sel_o <= 0;
        alu_muldiv_sel_o <= 0;
        shift_sel_o <= 0;
        is_branch_o <= 0;
        is_jal_o <= 0;
        is_jalr_o <= 0;
        regfile_we_o <= 1;
        regfile_input_sel_o <= 4;  // send Execute result into the RFU.
        we_o <= 0;
        re_o <= 0;
        dsize_sel_o <= 0;
        rd_addr_o <= 0;
        rs1_addr2fwd_o <= 0;
        rs2_addr2fwd_o <= 0;
        is_csr_instr_o <= 0;
        csr_imm_o <= 0;
        branch_hit_o <= 0;
        branch_decision_o <= 0;
        is_fencei_o <= 0;
        amo_type_o <= 0;
        is_amo_o <= 0;

        sys_jump_o <= 0;
        sys_jump_csr_addr_o <= 0;
        xcpt_valid_o <= xcpt_valid;
        xcpt_cause_o <= xcpt_cause;
        xcpt_tval_o <= xcpt_tval;
        csr_data2fwd_o <= 0;
        csr_addr2fwd_o <= 0;
    end
    else
    begin
        pc_o <= pc_i;
        fetch_valid_o <= fetch_valid_i;
        rs1_data2fwd_o <= rs1_data_i;
        rs2_data2fwd_o <= rs2_data_i;
        imm_o <= imm;
        inputA_sel_o <= inputA_sel;
        inputB_sel_o <= inputB_sel;
        operation_sel_o <= operation_sel;
        signex_sel_o <= signex_sel;
        alu_muldiv_sel_o <= alu_muldiv_sel;
        shift_sel_o <= shift_sel;
        is_branch_o <= rv32_branch;
        is_jal_o <= rv32_jal;
        is_jalr_o <= rv32_jalr;
        regfile_we_o <= regfile_we;
        regfile_input_sel_o <= regfile_input_sel;
        we_o <= we;
        re_o <= re;
        dsize_sel_o <= dsize_sel;
        rd_addr_o <= rd_addr;
        rs1_addr2fwd_o <= rs1_addr_o;
        rs2_addr2fwd_o <= rs2_addr_o;
        is_csr_instr_o <= rv32_csr & !((rv32_csrrs | rv32_csrrc) & rv32_instr[19 : 15] == 5'b00000);
        csr_imm_o <= csr_imm;
        branch_hit_o <= branch_hit_i;
        branch_decision_o <= branch_decision_i;
        is_fencei_o <= rv32_fencei;
        amo_type_o <= amo_type;
        is_amo_o <= rv32_amo;

        sys_jump_o <= rv32_mret | rv32_sret;
        sys_jump_csr_addr_o <= ({2{rv32_mret}} & 2'b11) | ({2{rv32_sret}} & 2'b01);
        xcpt_valid_o <= xcpt_valid_i;
        xcpt_cause_o <= xcpt_cause_i;
        xcpt_tval_o <= xcpt_tval_i;
        csr_data2fwd_o <= csr_data_i;
        csr_addr2fwd_o <= csr_addr_o;
    end
end

endmodule
