eisl-nctu/aquila-net/aquila_hw_network/network_module/iprepo/arp_server_subnet/hdl/verilog/arp_table_arpTable_ipAddress_V.v

// ==============================================================
// Vivado(TM) HLS - High-Level Synthesis from C, C++ and SystemC v2019.1 (64-bit)
// Copyright 1986-2019 Xilinx, Inc. All Rights Reserved.
// ==============================================================
`timescale 1 ns / 1 ps
module arp_table_arpTable_ipAddress_V_ram (addr0, ce0, d0, we0,  clk);

parameter DWIDTH = 32;
parameter AWIDTH = 8;
parameter MEM_SIZE = 256;

input[AWIDTH-1:0] addr0;
input ce0;
input[DWIDTH-1:0] d0;
input we0;
input clk;

(* ram_style = "block" *)reg [DWIDTH-1:0] ram[0:MEM_SIZE-1];

initial begin
    $readmemh("./arp_table_arpTable_ipAddress_V_ram.dat", ram);
end



always @(posedge clk)  
begin 
    if (ce0) 
    begin
        if (we0) 
        begin 
            ram[addr0] <= d0; 
        end 
    end
end


endmodule

`timescale 1 ns / 1 ps
module arp_table_arpTable_ipAddress_V(
    reset,
    clk,
    address0,
    ce0,
    we0,
    d0);

parameter DataWidth = 32'd32;
parameter AddressRange = 32'd256;
parameter AddressWidth = 32'd8;
input reset;
input clk;
input[AddressWidth - 1:0] address0;
input ce0;
input we0;
input[DataWidth - 1:0] d0;



arp_table_arpTable_ipAddress_V_ram arp_table_arpTable_ipAddress_V_ram_U(
    .clk( clk ),
    .addr0( address0 ),
    .ce0( ce0 ),
    .we0( we0 ),
    .d0( d0 ));

endmodule
