eisl-nctu/aquila-net/aquila_hw_network/network_module/iprepo/arp_server_subnet/hdl/verilog/fifo_w128_d4_A.v

// ==============================================================
// Vivado(TM) HLS - High-Level Synthesis from C, C++ and SystemC v2019.1 (64-bit)
// Copyright 1986-2019 Xilinx, Inc. All Rights Reserved.
// ==============================================================

`timescale 1 ns / 1 ps

module fifo_w128_d4_A_shiftReg (
    clk,
    data,
    ce,
    a,
    q);

parameter DATA_WIDTH = 32'd128;
parameter ADDR_WIDTH = 32'd2;
parameter DEPTH = 3'd4;

input clk;
input [DATA_WIDTH-1:0] data;
input ce;
input [ADDR_WIDTH-1:0] a;
output [DATA_WIDTH-1:0] q;

reg[DATA_WIDTH-1:0] SRL_SIG [0:DEPTH-1];
integer i;

always @ (posedge clk)
    begin
        if (ce)
        begin
            for (i=0;i<DEPTH-1;i=i+1)
                SRL_SIG[i+1] <= SRL_SIG[i];
            SRL_SIG[0] <= data;
        end
    end

assign q = SRL_SIG[a];

endmodule

module fifo_w128_d4_A (
    clk,
    reset,
    if_empty_n,
    if_read_ce,
    if_read,
    if_dout,
    if_full_n,
    if_write_ce,
    if_write,
    if_din);

parameter MEM_STYLE   = "shiftreg";
parameter DATA_WIDTH  = 32'd128;
parameter ADDR_WIDTH  = 32'd2;
parameter DEPTH       = 3'd4;

input clk;
input reset;
output if_empty_n;
input if_read_ce;
input if_read;
output[DATA_WIDTH - 1:0] if_dout;
output if_full_n;
input if_write_ce;
input if_write;
input[DATA_WIDTH - 1:0] if_din;

wire[ADDR_WIDTH - 1:0] shiftReg_addr ;
wire[DATA_WIDTH - 1:0] shiftReg_data, shiftReg_q;
wire                     shiftReg_ce;
reg[ADDR_WIDTH:0] mOutPtr = ~{(ADDR_WIDTH+1){1'b0}};
reg internal_empty_n = 0;
reg internal_full_n = 1;

assign if_full_n = internal_full_n;
assign if_empty_n = internal_empty_n;
assign shiftReg_data = if_din;
assign if_dout = shiftReg_q;

always @ (posedge clk) begin
    if (reset == 1'b1)
    begin
        mOutPtr <= ~{ADDR_WIDTH+1{1'b0}};
        internal_empty_n <= 1'b0;
        internal_full_n <= 1'b1;
    end
    else begin
        if (((if_read & if_read_ce) == 1 & internal_empty_n == 1) && 
            ((if_write & if_write_ce) == 0 | internal_full_n == 0))
        begin
            mOutPtr <= mOutPtr - 3'd1;
            if (mOutPtr == 3'd0)
                internal_empty_n <= 1'b0;
            internal_full_n <= 1'b1;
        end 
        else if (((if_read & if_read_ce) == 0 | internal_empty_n == 0) && 
            ((if_write & if_write_ce) == 1 & internal_full_n == 1))
        begin
            mOutPtr <= mOutPtr + 3'd1;
            internal_empty_n <= 1'b1;
            if (mOutPtr == DEPTH - 3'd2)
                internal_full_n <= 1'b0;
        end 
    end
end

assign shiftReg_addr = mOutPtr[ADDR_WIDTH] == 1'b0 ? mOutPtr[ADDR_WIDTH-1:0]:{ADDR_WIDTH{1'b0}};
assign shiftReg_ce = (if_write & if_write_ce) & internal_full_n;

fifo_w128_d4_A_shiftReg 
#(
    .DATA_WIDTH(DATA_WIDTH),
    .ADDR_WIDTH(ADDR_WIDTH),
    .DEPTH(DEPTH))
U_fifo_w128_d4_A_ram (
    .clk(clk),
    .data(shiftReg_data),
    .ce(shiftReg_ce),
    .a(shiftReg_addr),
    .q(shiftReg_q));

endmodule  
