eisl-nctu/aquila-net/(notices)

Notices in the files:
aquila_lwip/sw/socket_echo/lwipopts.h:
Copyright (c) 2001-2003 Swedish Institute of Computer Science.
All rights reserved.
